riggedlab/hark/enclosure/dt1-carved/previews/front-closeup.png

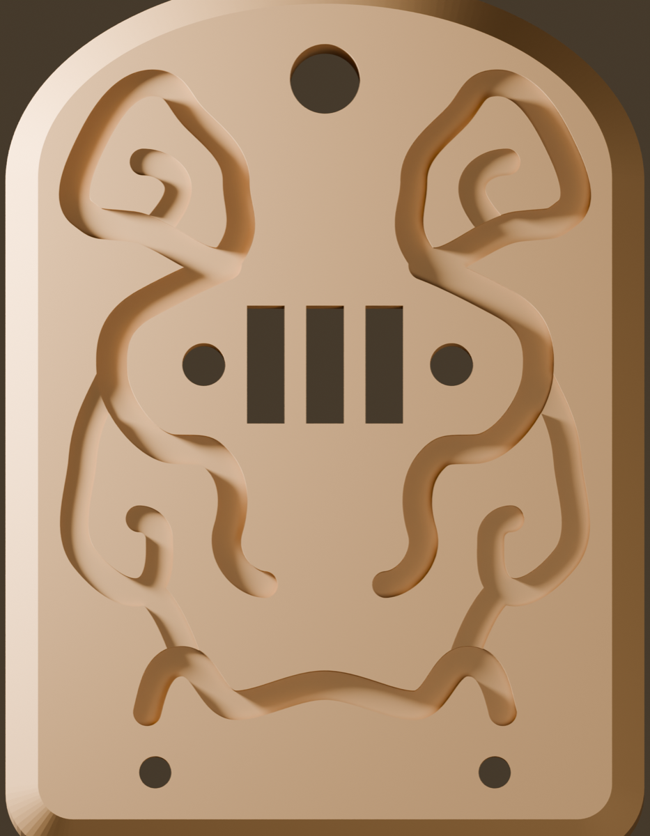
enclosure/dt1-carved/previews/front-closeup.png
