riggedlab/hark/enclosure/dt1-carved/previews/front-inside.png

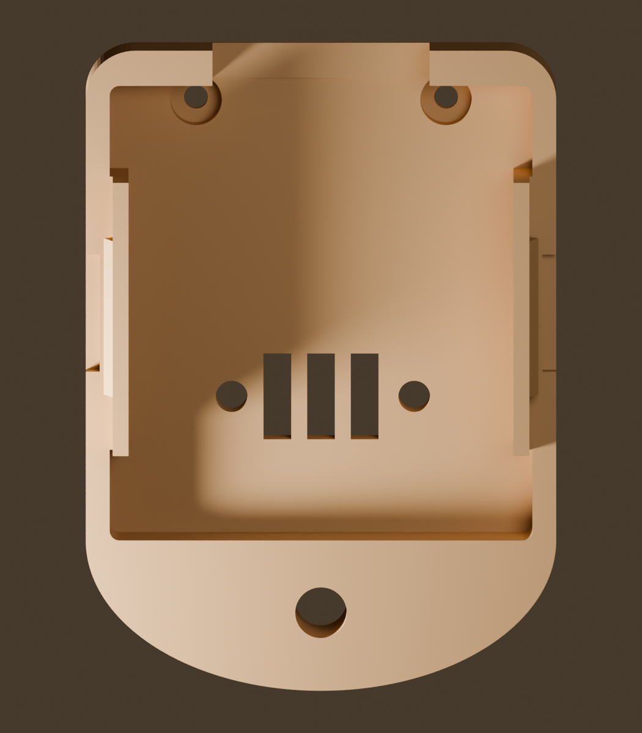
enclosure/dt1-carved/previews/front-inside.png
