riggedlab/hark/enclosure/dt1-plain/previews/front-inside.png

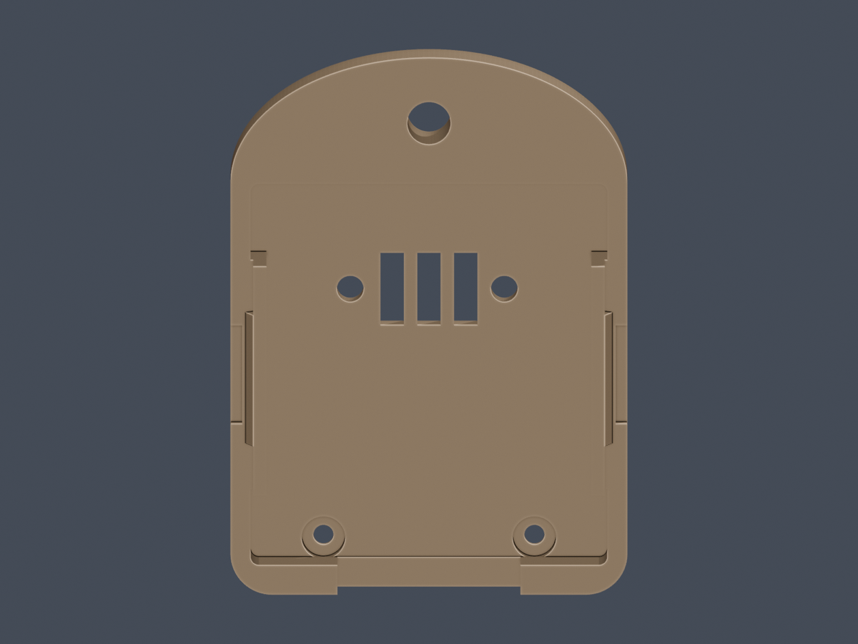
enclosure/dt1-plain/previews/front-inside.png
