riggedlab/hark/enclosure/v1/previews/back-slot.png

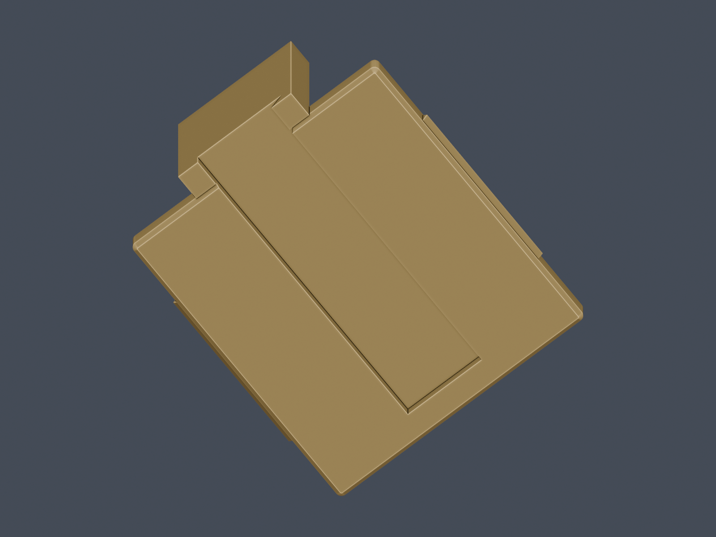
enclosure/v1/previews/back-slot.png
