riggedlab/hark/enclosure/v1/previews/clip-side.png

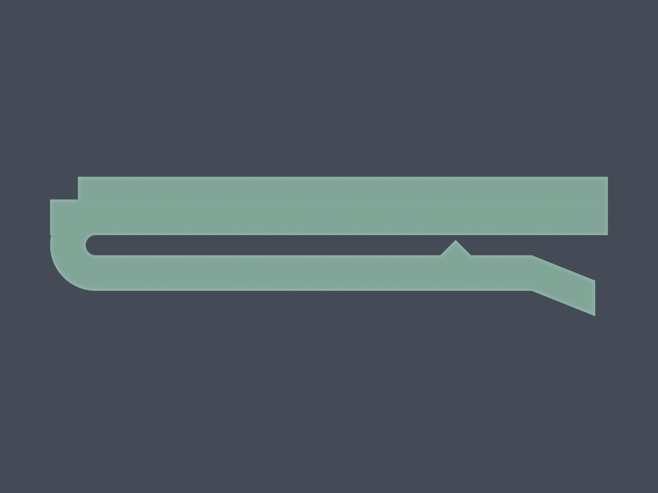
enclosure/v1/previews/clip-side.png
