riggedlab/hark/enclosure/v1/previews/exploded-back.png

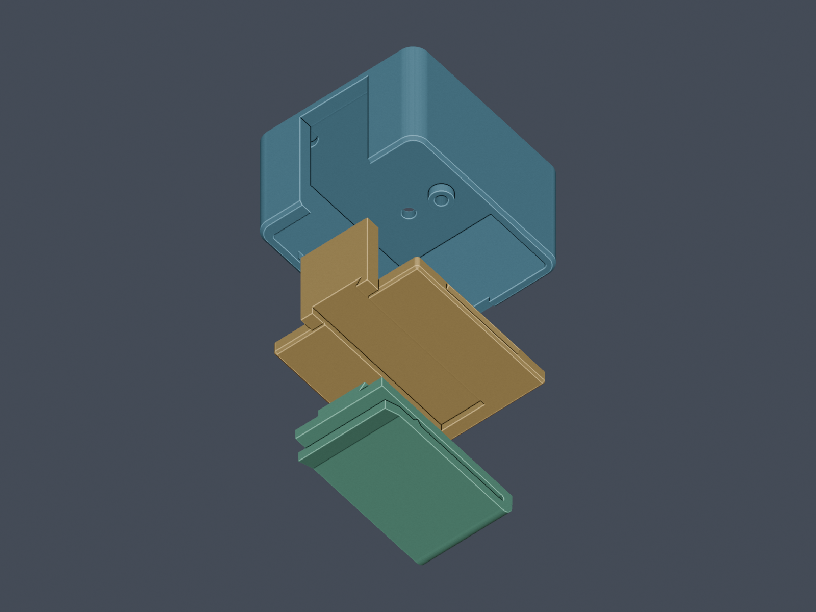
enclosure/v1/previews/exploded-back.png
