riggedlab/hark/enclosure/v1/previews/exploded.png

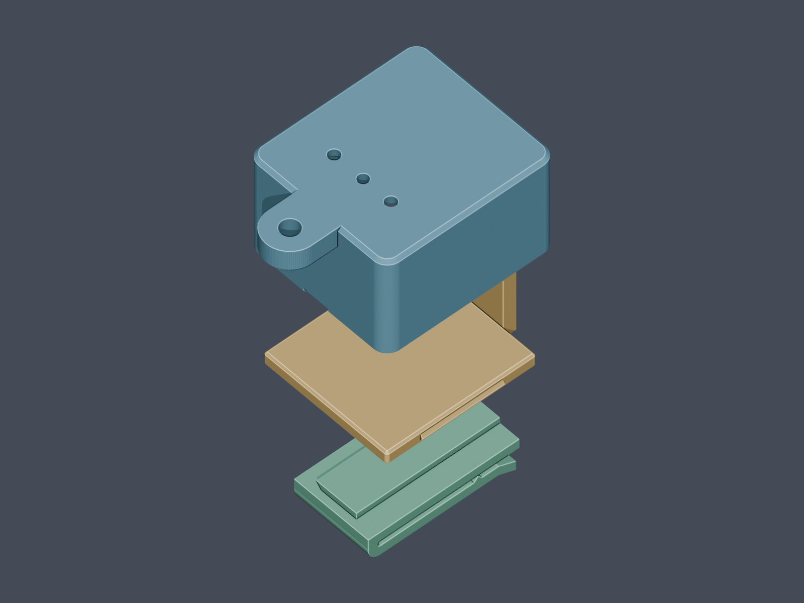
enclosure/v1/previews/exploded.png
