riggedlab/hark/enclosure/v1/previews/front-inside.png

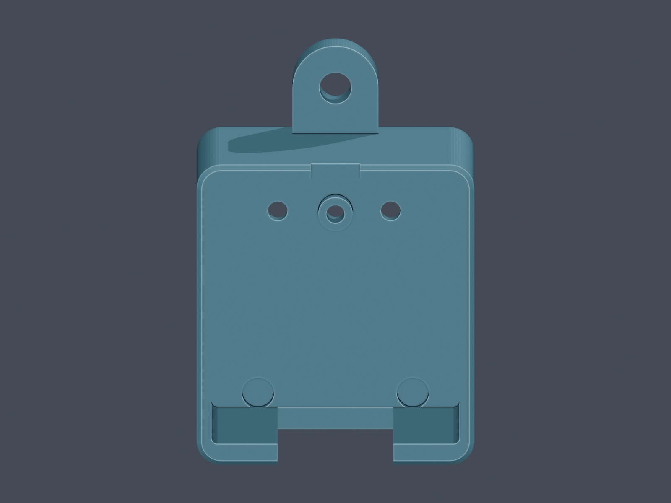
enclosure/v1/previews/front-inside.png
