riggedlab/hark/enclosure/v1/previews/front-orthographic.png

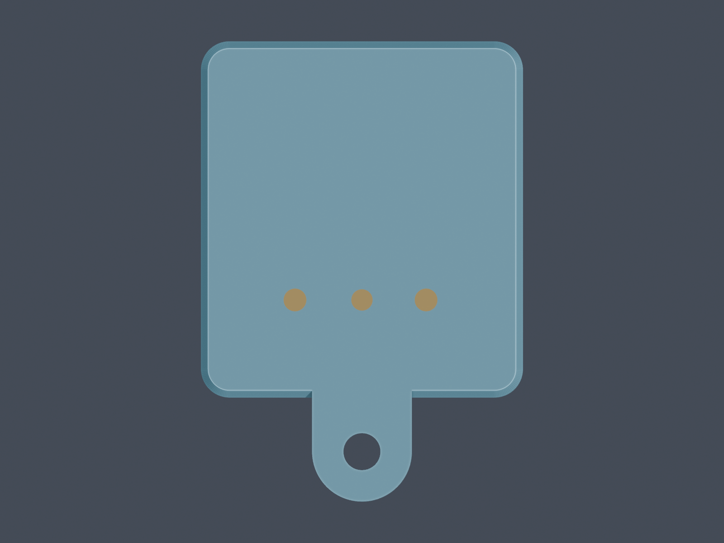
enclosure/v1/previews/front-orthographic.png
