riggedlab/hark/shopping-list.md

# 购物清单 · 全天语音记录器

> 价格为参考价，以实际下单为准。
>
> ⚠️ 要自己焊锂电池。买之前先读 [docs/hardware.md 的安全须知](docs/hardware.md#安全须知)。

## 一、开发板和电池

| 物品 | 规格 / 淘宝搜索 | 数量 | 参考价 |
|---|---|---|---|
| XIAO nRF54L15 Sense | 不带排针的版本。只剩焊好排针的就买那个，之后把针剪平 | 1 | ~110–130 元 |
| 锂电池 402020（~120–150mAh，~3g） | `402020 聚合物锂电池 3.7V 带保护板` | 1 | ~10–15 元 |
| USB-C 数据线 | 必须能**传数据**（家里有就不用买） | 1 | ~10 元 |

> ⚠️ 板子名字里一定要有 **Sense**，不带 Sense 的版本没有麦克风。建议在 Seeed 官方店或授权店买。
>
> 电池要求：聚合物软包、**带保护板**、裸线或 1.25mm 插头，最好有 UN38.3 或 3C 认证，不要只挑最便宜的。

## 二、焊接工具和耗材

| 物品 | 规格 / 淘宝搜索 | 数量 | 参考价 |
|---|---|---|---|
| 电烙铁套装 | 绿林 GREENER 60W 数显调温套装（220V） | 1 | ~99 元 |
| 焊锡丝 | `无铅焊锡丝 SAC305 0.6mm 松香芯` | 1 卷 | ~20–30 元 |
| 助焊剂 | `免清洗助焊膏`（**不要**买含氯化锌的焊油） | 1 管 | ~15 元 |
| 吸锡带 | `吸锡带 2mm` | 1 卷 | ~10 元 |
| 剪脚钳 | 平口斜口钳（宝工、三峰等） | 1 | ~20–40 元 |
| 导线 | `30AWG 硅胶线` 红黑各一卷 | 1 套 | ~10 元 |
| 热缩管 | `阻燃热缩管 套装` | 1 盒 | ~10 元 |
| 高温胶带 | `聚酰亚胺胶带 10mm` | 1 卷 | ~10 元 |
| 万用表 | 优利德 UT33 系列 | 1 | ~60–100 元 |
| 异丙醇（可选） | `99% 异丙醇 IPA`，用来清洗助焊剂残留 | 1 瓶 | ~15 元 |

## 三、安全用品

| 物品 | 规格 / 淘宝搜索 | 数量 | 参考价 |
|---|---|---|---|
| 护目镜 | `防冲击护目镜 GB14866 防雾`（戴眼镜的选"可套近视镜"） | 1 | ~20–30 元 |
| 硅胶焊接垫 | `硅胶焊接垫 耐高温` | 1 | ~15 元 |
| 金属盒或陶瓷碗 | 用来放电池、充电（家里有就不用买） | 1 | – |

## 四、外壳和佩戴

| 物品 | 说明 | 参考价 |
|---|---|---|
| PLA 耗材 | 简易款用黑色普通 PLA，谛听款用木粉 PLA。一个外壳约 6g。**不要用金属粉耗材**，会挡蓝牙 | 一卷 ~50–80 元 |
| 挂绳 | 任意细绳 | – |

> 没有 3D 打印机可以找网上的打印服务，上传 `enclosure/dt1-plain` 或 `enclosure/dt1-carved` 里的 STL。

## 五、可选（以后再买）

| 物品 | 用途 | 参考价 |
|---|---|---|
| Nordic PPK2 | 精确测量功耗（µA 级），优化续航时用 | ~600–700 元 |

---

**合计**：板子和电池约 130–150 元；焊接工具和安全用品第一次买约 300–400 元（家里有的不用买）。

**目标**：整机 ≤ 20g（估计 10–16g），续航一整天（还没实测）。外壳外形 23.7 × 32.8 × 15 mm。接线和装配见 [docs/hardware.md](docs/hardware.md)。
