riggedlab/hark/enclosure/dt1-carved/parts/case-front.stl

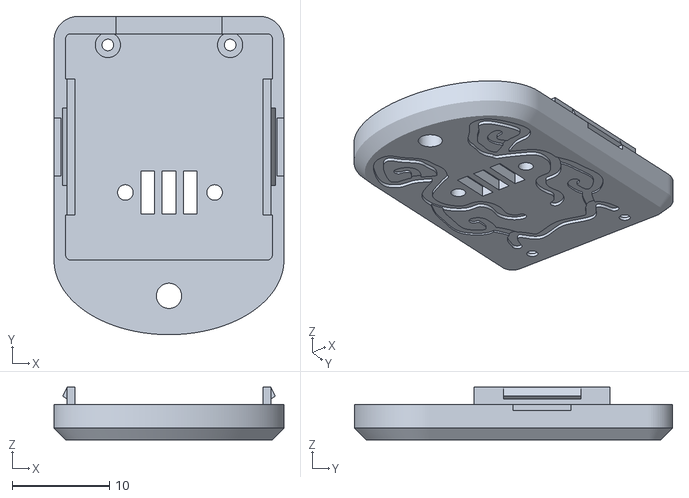
[picture p12: CAD file, 2026-11-13]
enclosure/dt1-carved/parts/case-front.stl
23.7 x 32.8 x 5.43
