riggedlab/hark/enclosure/dt1-plain/parts/case-front.stl

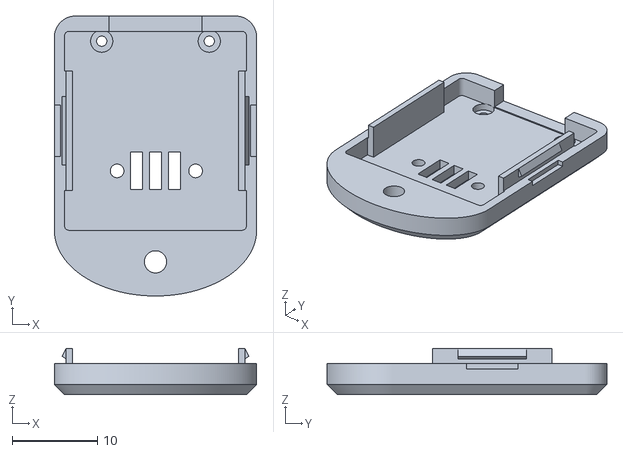
[picture p13: CAD file, 2026-11-13]
enclosure/dt1-plain/parts/case-front.stl
23.7 x 32.8 x 5.43
