riggedlab/hark/enclosure/dt1-carved/parts/case-back.stl

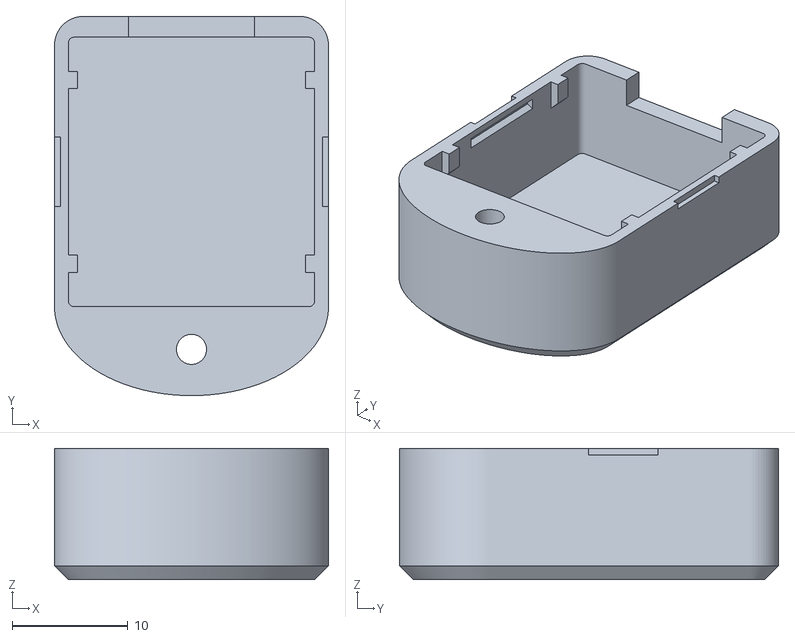
[picture p14: CAD file, 2026-11-13]
enclosure/dt1-carved/parts/case-back.stl
23.7 x 32.8 x 11.4
