riggedlab/hark/enclosure/v1/parts/clip.stl

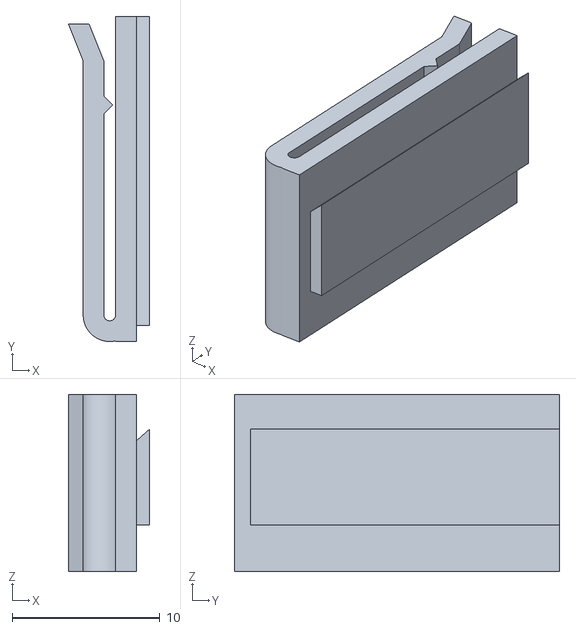
[picture p15: CAD file, 2026-11-12]
enclosure/v1/parts/clip.stl
5.50 x 22.0 x 12.0
