riggedlab/hark/enclosure/v1/parts/case-front.stl

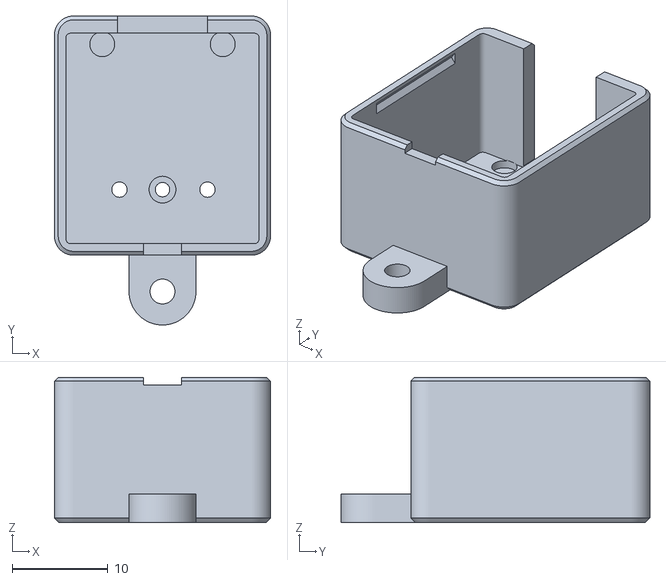
[picture p16: CAD file, 2026-11-12, an earlier design]
enclosure/v1/parts/case-front.stl
22.6 x 32.3 x 15.2
