riggedlab/hark/enclosure/v1/parts/case-back.stl

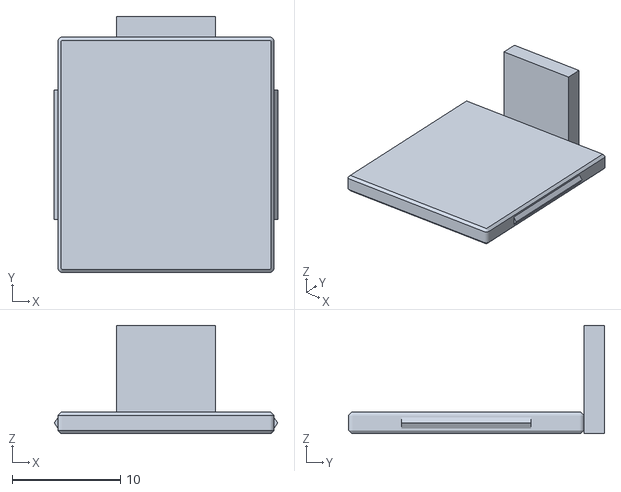
[picture p17: CAD file, 2026-11-12, an earlier design]
enclosure/v1/parts/case-back.stl
20.7 x 23.7 x 10.0
