riggedlab/hark/docs/asr-guides/apple-silicon-mlx.md

# Apple Silicon 本地 Qwen3-ASR + 3D-Speaker 实战调优笔记

以下是我在 Apple M 系列 Mac（16GB 统一内存）上全天实测（含挂脖子佩戴与放工位桌面远近场混录）沉淀下来的配置与避坑记录，供按 [Hark 增强接口契约](README.md) 纯本地跑通的朋友直接参考。

## 1. 推荐模型组合

- **前置切分（必做）**：`Silero VAD`（`sherpa-onnx` 内置）。全天录音大量时间是环境底噪，不做 VAD 直接喂给大模型既浪费算力，又极易在静音段触发“幻觉字幕”。
- **主力转写**：`mlx-audio` 跑 `mlx-community/Qwen3-ASR-1.7B-8bit`（配合 `Qwen3-ForcedAligner` 拿字级时间戳；备选可用 `sherpa-onnx` 跑 `SenseVoice` int8）。16GB 内存常驻峰值低于 6GB，日常办公不卡顿。
- **说话人分离与声纹**：`sherpa-onnx` 的 `OfflineSpeakerDiarization`（分段用 `pyannote-segmentation-3-0`，声纹提取用中文训练的 `3dspeaker_speech_campplus_sv_zh-cn_16k-common.onnx`，192 维 CAM++；接口返回时建议带上 `"embedding_model": "3dspeaker-cam++"`）。

## 2. 四个实测踩出来的关键修正

### 坑 1：按 VAD 碎片段逐条识别，会导致断句支离破碎、交界处吞字
如果把 VAD 切出的两三秒小片段单独喂给模型，模型看不到上下文，会把「距离麦克风十厘米处正常」切成「距离麦克。/ 厘米处正常。」。
- **做法**：VAD 切出片段后先向后合并——相邻间隔 `≤ 2.0s` 且合并总跨度 `≤ 25.0s` 的并成一个长段，从原音频连续截取 `[首段开头 - 0.2s, 末段结尾 + 0.2s]`（**保留中间的自然短停顿**，停顿本身就是标点线索）。若单个持续背景声让某段超过 `25s`，在 `[15s, 25s]` 区间找能量最低的 `0.1s` 窗口硬切开，保证送模长度永远 `≤ 25.4s`。

### 坑 2：风扇底噪、哼歌或远场模糊音会触发大模型 `max_tokens` 复读死循环
全天 7 小时实测里，默认 `max_tokens=8192` 遇到哼歌或持续底噪会吐出几千字重复词，还会把远场模糊中文误判成粤语、印地语或日语。
- **做法**：
  1. **按音频时长卡死预算**：`max_tokens = min(300, max(32, int(chunk_sec * 10 + 16)))`。
  2. **显式传 `language="Chinese"`**（实测 `API`、`GPU`、`CI` 等常见中英混杂术语仍能正常保留）。
  3. **对齐前加复读熔断**：送 `ForcedAligner` 之前，只要撞满 `max_tokens`、或 `len(text) >= 20` 时 UTF-8 的 `zlib` 压缩比 `> 2.4`、或任意 1~6 字子串连续重复 `>= 8` 次，直接二分重试一次；仍触发则判定为哼歌/底噪并丢弃该段。

### 坑 3：放工位桌面上远场说话声音偏轻，会被漏检或吞进主说话人
设备有时挂在身上（0.3m），有时随手放在桌面（1.5~2m）：
- **送 ASR 前做整段线性增益抬升**：待识别段峰值若 `< -12 dBFS`（`0.25`），整段乘一个固定标量抬到 `-3 dBFS`（上限放大 `+15 dB`），不做滑窗非线性压缩。
- **按单句归属说话人，不要 25 秒长段多数票**：先拿字级时间戳按标点（及持续 `>= 0.8s` 的 `pyannote` 说话人切换点）切成单句，再逐句按时间重叠分配本地说话人；`pyannote` 参数调为 `min_duration_on=0.2`、`min_duration_off=0.3`，更容易抓到对话里的短接话。

### 坑 4：千万不要在“滑窗动态拉平”后的波形上提声纹
3D-Speaker（CAM++）内部算 log Mel-Fbank 并做减均值归一化（CMN），对整句话乘固定常数在数学上完全抵消，模型天生不怕整句声音小；反过来如果先做 1 秒滑窗动态增益再提声纹，会扭曲重音包络、把字间底噪抬高掺进均值，导致声纹区分度暴跌。
- **铁律**：`speakers[].embedding` 必须回**原始未做动态拉平的 16kHz 波形**上截取累计时长 `>= 2.0s` 的语音段提取，按片段时长加权平均后再做 L2 归一化。
