riggedlab/hark/enclosure/dt1-carved/previews/assembly-back.png

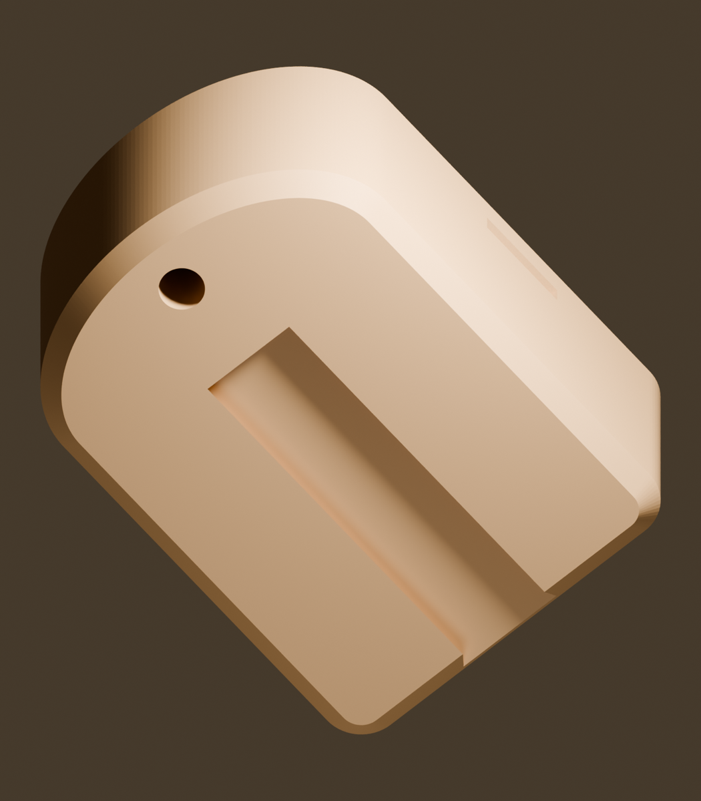
enclosure/dt1-carved/previews/assembly-back.png
