riggedlab/hark/enclosure/dt1-plain/previews/assembly-back.png

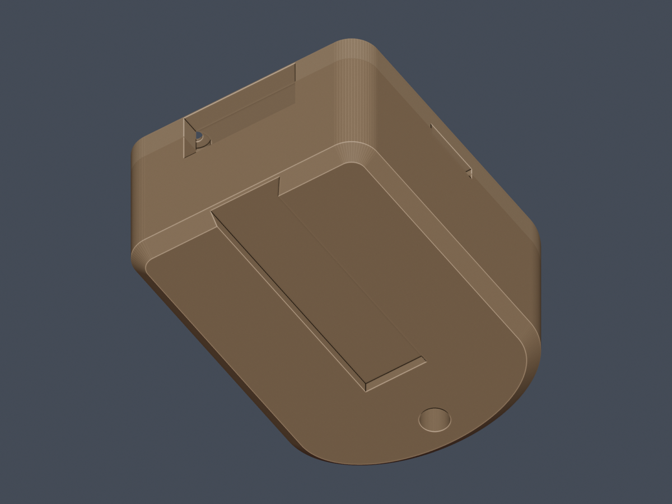
enclosure/dt1-plain/previews/assembly-back.png
