riggedlab/hark/enclosure/v1/previews/assembly-back.png

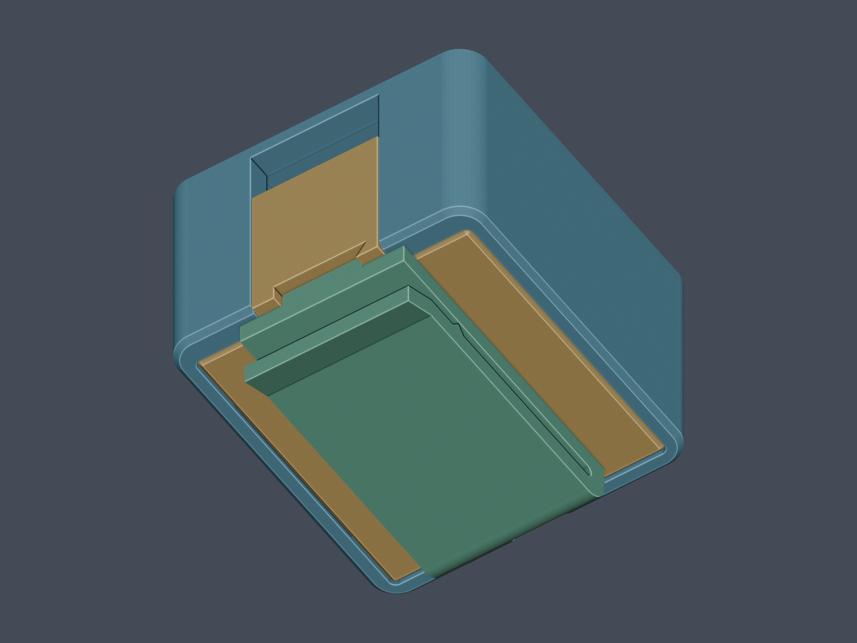
enclosure/v1/previews/assembly-back.png
