riggedlab/hark/enclosure/v1/previews/assembly-front.png

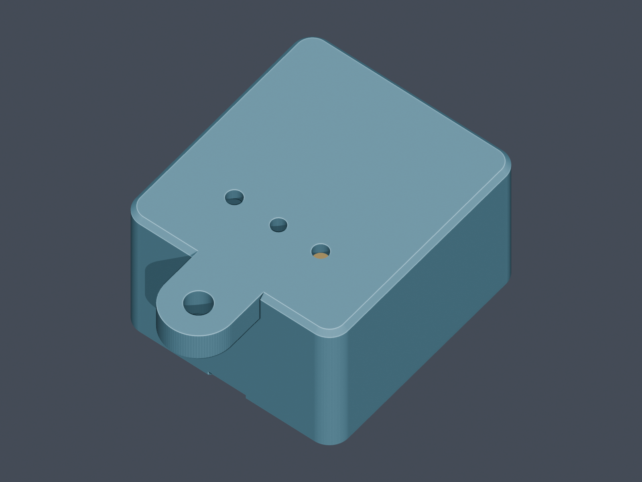
enclosure/v1/previews/assembly-front.png
