riggedlab/hark/enclosure/v1/previews/print-layout.png

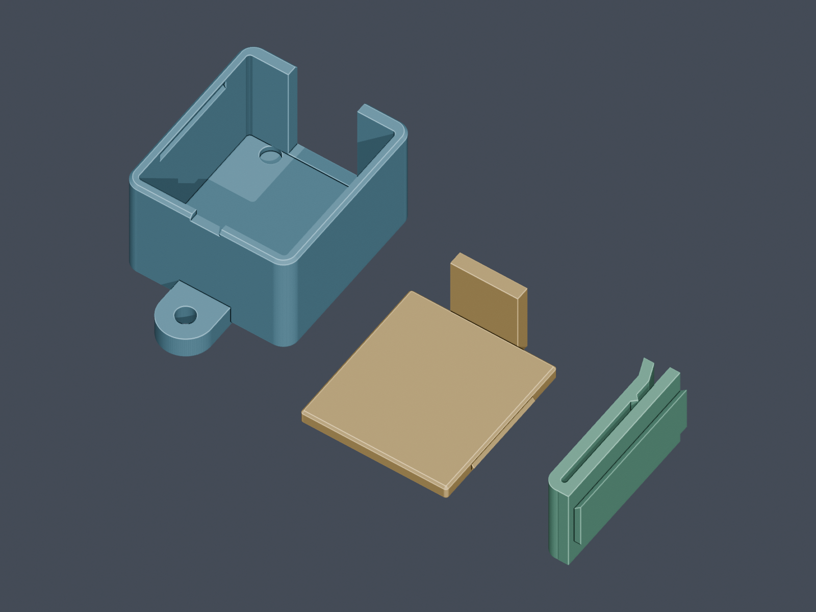
enclosure/v1/previews/print-layout.png
