riggedlab/hark/(commit log)

2026-11-12 feat: initial open-source alpha release of Hark (v0.1.0)
    [case-back.stl, case-front.stl, clip.stl]
2026-11-12 feat(android): add switchable on-phone direct ASR and cloud mailbox modes
2026-11-13 perf(android): 120Hz smooth scrolling & spectrum, top status popover, Hark branding & guided ASR setup
2026-11-13 feat(voiceprint,loudness): tighten CAM++ speaker precision and add per-sentence active speech dBFS
2026-11-13 feat(android): replace fixed 5-min cut with conversation-aware chunking
2026-11-13 feat(proximity,firmware): add on-device voice proximity/media detection and restore fixed +12dB mic gain
2026-11-13 feat(android): redesign timeline with switchable Dialogue & Editorial Apple-style streams
2026-11-13 docs(hardware): add DT-1 hardware guide, wiring diagram and two printable enclosures
    - docs/hardware.md: safety notes first (Li-po, soldering, wearing, recording consent), BOM, wiring steps, buttons/LEDs, enclosure and assembly, verified vs. unverified
    - docs/images/dt1-wiring.svg: back-side battery wiring and in-case stack-up
    - enclosure/dt1-plain (black PLA) and enclosure/dt1-carved (wood PLA, carved face): STL, Creality Print project, .blend, previews
    - enclosure/build_dt1.py: standalone Blender script that rebuilds both enclosures; --check matches the committed STLs exactly; verify_dt1.py runs the full check
    - shopping-list.md trimmed to the current build; README links the hardware guide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
    [case-back.stl, case-front.stl, hark-dt1-carved-K3.3mf, hark-dt1-carved.blend, hark-dt1-plain-K3.3mf, hark-dt1-plain.blend]
2026-11-13 docs: restructure README for first-time builders, show enclosure renders
    Move CLI reference to docs/cli.md, build/test/release to docs/development.md,
    and shopping-list.md into docs/.
2026-11-13 fix(enclosure): stop tracking .blend/.3mf so the OSS audit passes
    The .blend files embed a local home path. Both formats are already in
    .gitignore and banned by tools/oss_audit.py; build_dt1.py --blend
    regenerates the .blend, and slicing settings now live in the READMEs.
    [hark-dt1-carved-K3.3mf, hark-dt1-carved.blend, hark-dt1-plain-K3.3mf, hark-dt1-plain.blend]
2026-11-13 docs: phone-first README, enclosure fit guidance, lark-style CLI & skill install
    - README: phone direct-ASR as the recommended path, desktop/mailbox marked
    as not yet heavily used, stronger safety callout, issue guidance
    - hardware: fit tolerance section (foam tape for loose, regenerate for tight)
    - CLI: --version, tools/install-cli.sh with SHA256 check, release assets
    renamed to hark-cli-<os>-<arch> (+darwin/amd64); skill via npx skills add
    - SKILL.md: requires metadata, install step, proximity-first guidance
    replacing the stale AGC-based dB thresholds
    - issue templates for bugs and hardware feedback
